codesqueak/7_Segment_Clock/README.md

# 7 Segment 24 Hour LED Clock

A pure logic, 7 segment 24 hour clock using large 7 segment displays

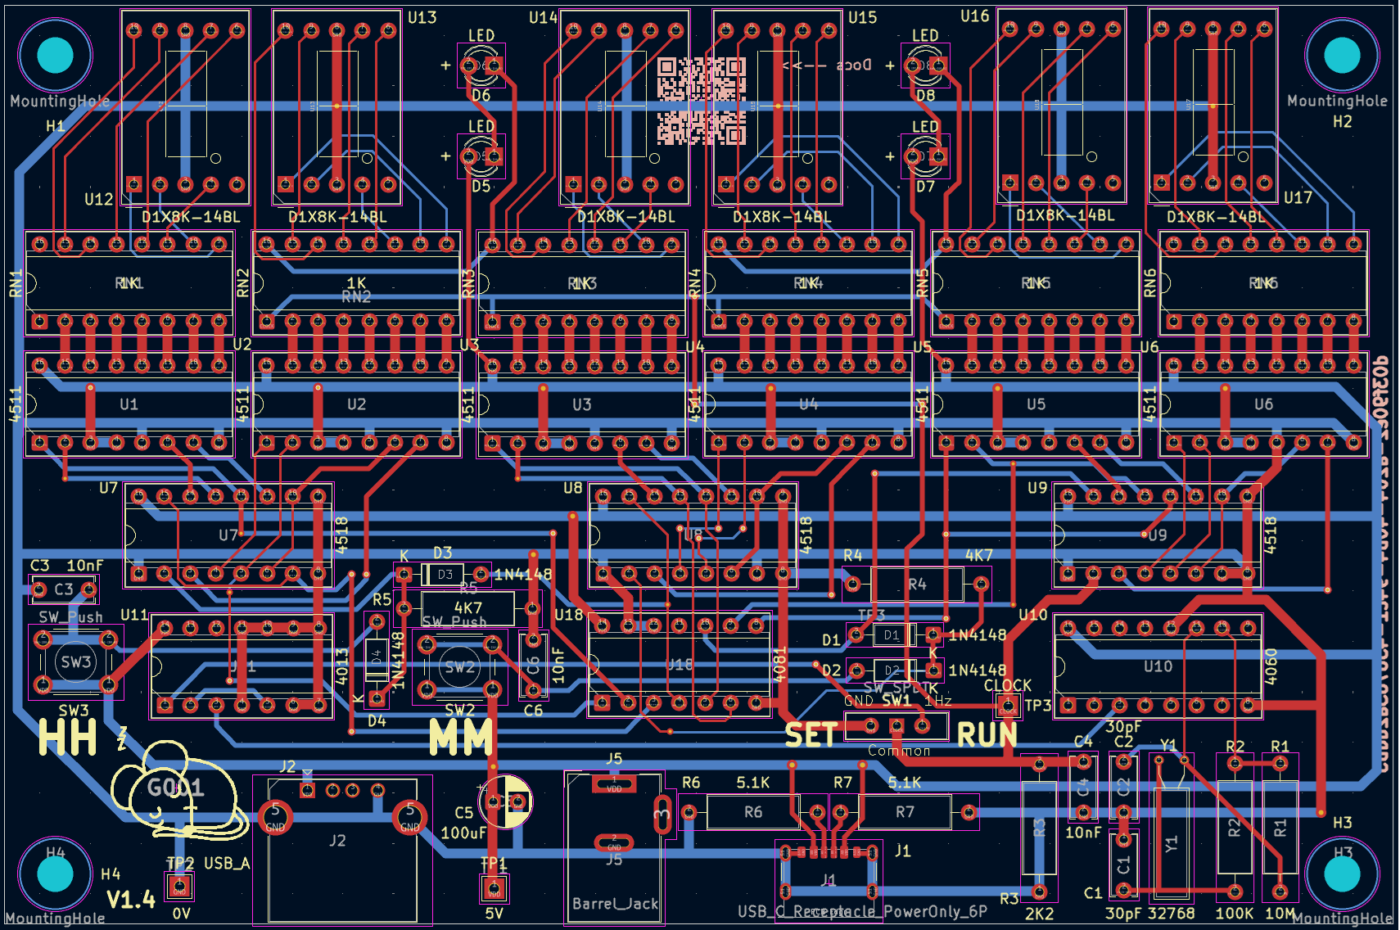
[picture p1: circuit.png]
PCB Circuit Layout
