codesqueak/7_Segment_Clock/kicad/clock.kicad_pcb

## KiCad design kicad/clock.kicad_pcb (2026-01-08)

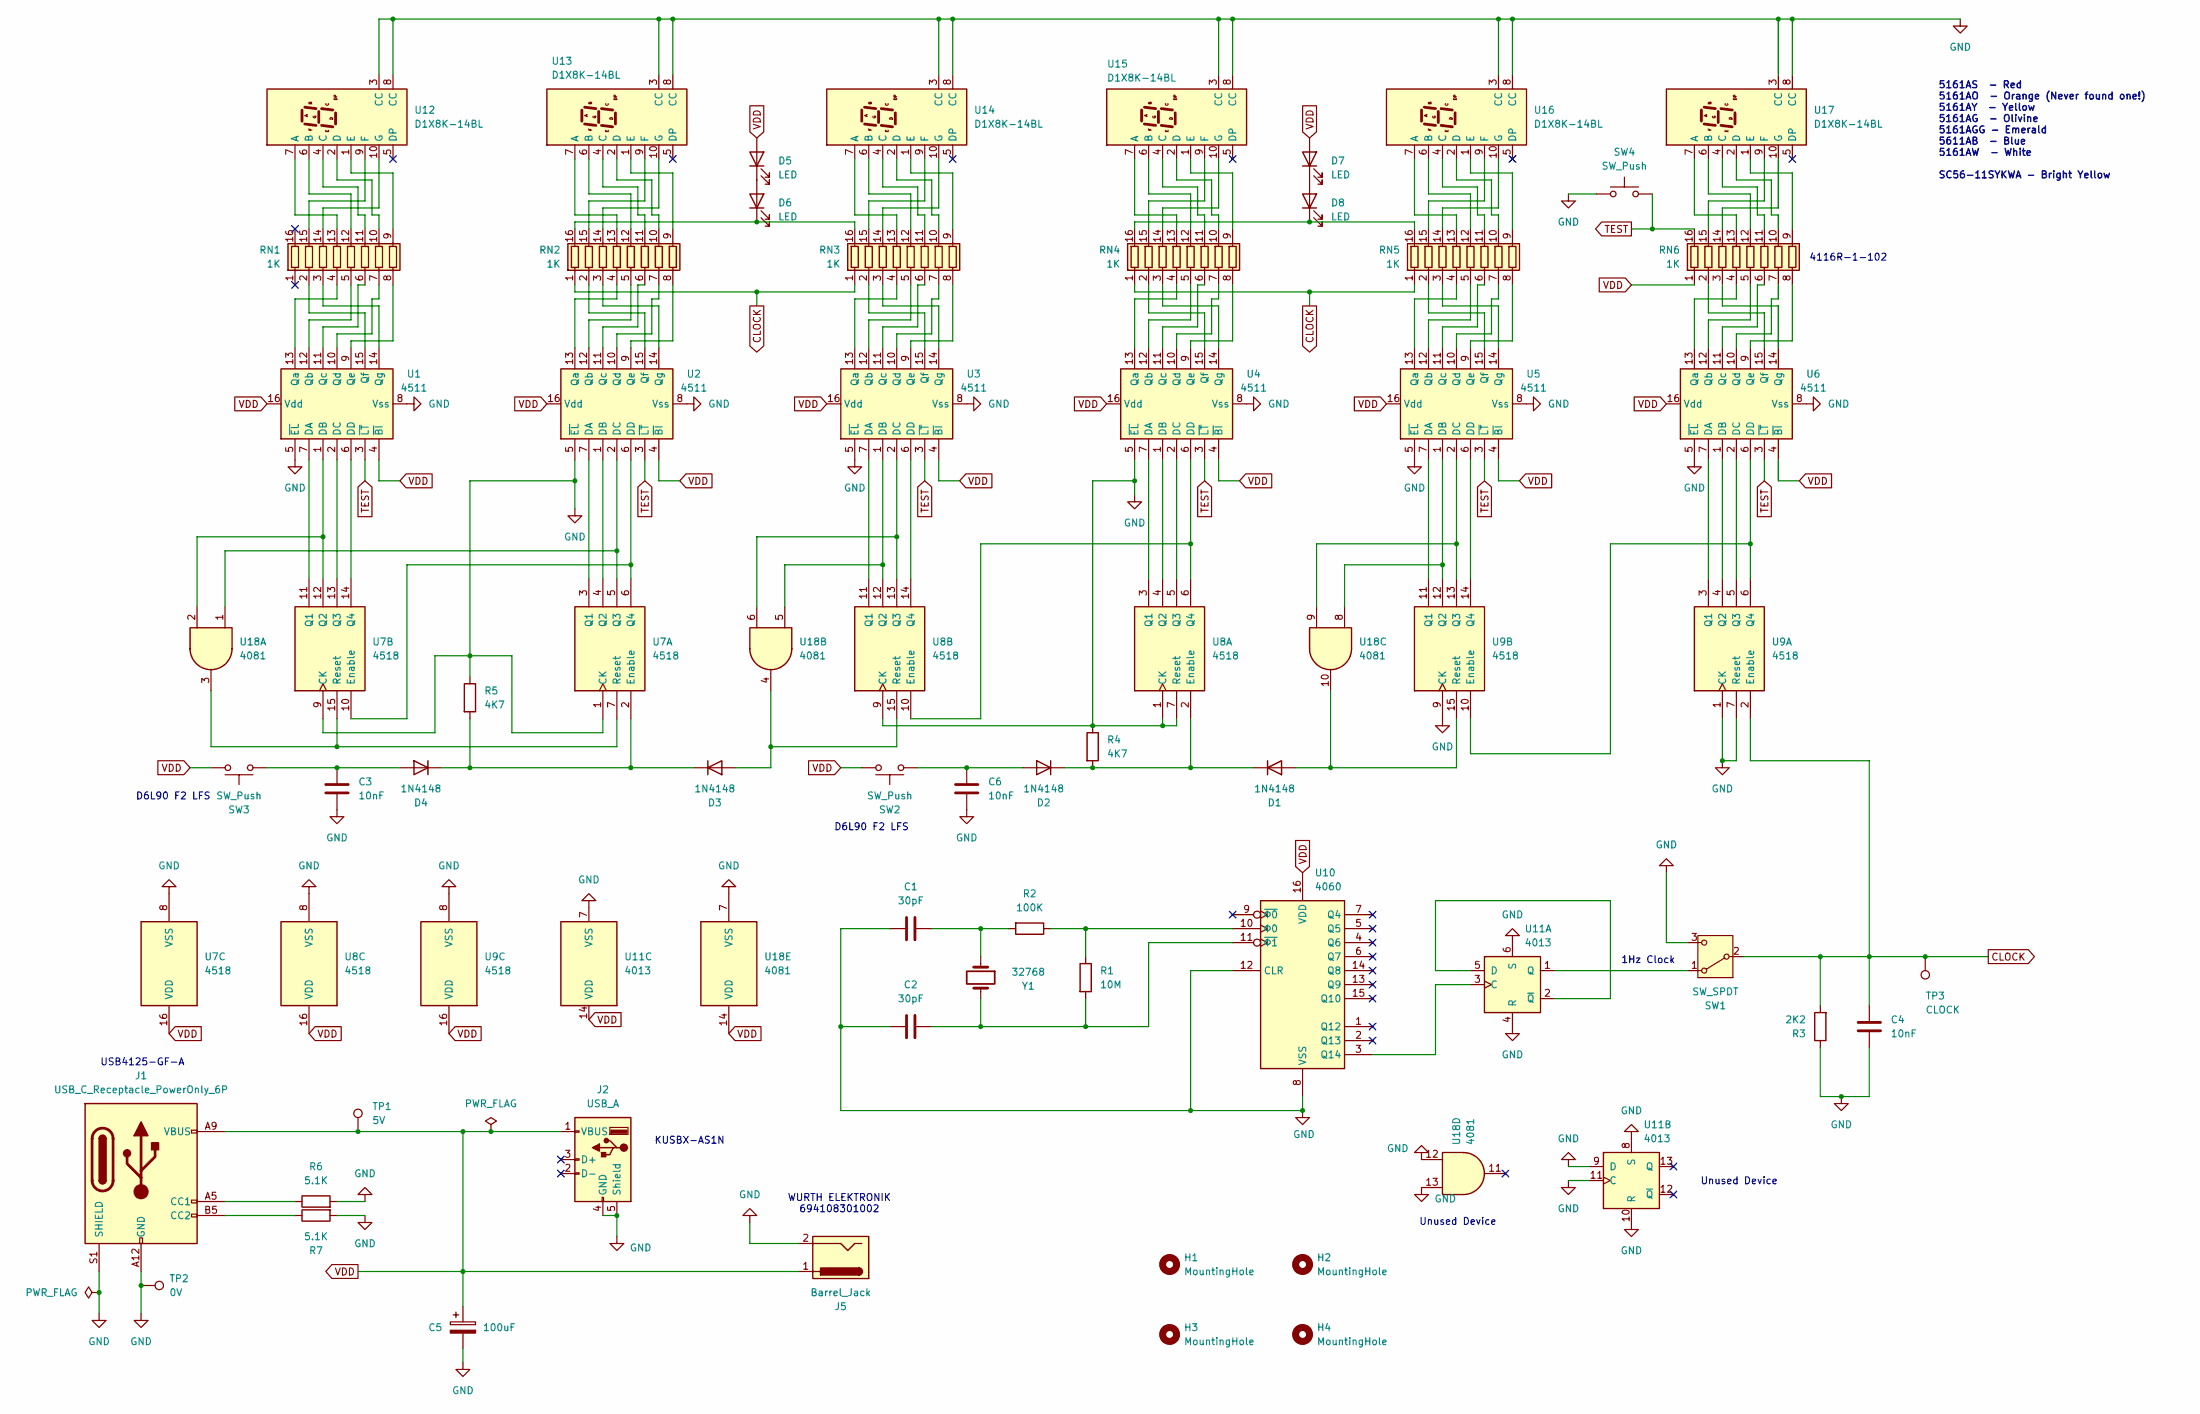
[picture p11: schematic clock.kicad_sch, Logic Clock]

Parts:
C1, C2: 30pF; C_Disc_D6.0mm_W2.5mm_P5.00mm
C3, C4, C6: 10nF; C_Disc_D6.0mm_W2.5mm_P5.00mm
C5: 100uF; CP_Radial_D5.0mm_P2.50mm
D1, D2, D3, D4: 1N4148; D_DO-35_SOD27_P7.62mm_Horizontal
D5, D6, D7, D8: LED; LED_D3.0mm
H1, H2, H3, H4: MountingHole; MountingHole_3.5mm
J1: USB_C_Receptacle_PowerOnly_6P; USB_C_Receptacle_GCT_USB4125-xx-x-0190_6P_TopMnt_Horizontal
J2: USB_A; USB_A_Kycon_KUSBX-AS1N-B_Horizontal
J5: Barrel_Jack; BarrelJack_Wuerth_6941xx301002
R1: 10M; R_Axial_DIN0309_L9.0mm_D3.2mm_P12.70mm_Horizontal
R2: 100K; R_Axial_DIN0309_L9.0mm_D3.2mm_P12.70mm_Horizontal
R3: 2K2; R_Axial_DIN0309_L9.0mm_D3.2mm_P12.70mm_Horizontal
R4, R5: 4K7; R_Axial_DIN0309_L9.0mm_D3.2mm_P12.70mm_Horizontal
R6, R7: 5.1K; R_Axial_DIN0309_L9.0mm_D3.2mm_P12.70mm_Horizontal
RN1, RN2, RN3, RN4, RN5, RN6: 1K; DIP-16_W7.62mm_Socket
SW1: SW_SPDT; SW_Slide-03_Pin-2-Common_10x2.5x6.4_P2.54mm
SW2, SW3, SW4: SW_Push; SW_PUSH_6mm_H5mm
TP1: 5V; TestPoint_THTPad_2.0x2.0mm_Drill1.0mm
TP2: 0V; TestPoint_THTPad_2.0x2.0mm_Drill1.0mm
TP3: CLOCK; TestPoint_THTPad_2.0x2.0mm_Drill1.0mm
U1, U2, U3, U4, U5, U6: 4511; DIP-16_W7.62mm_Socket
U7, U8, U9: 4518; DIP-16_W7.62mm_Socket
U10: 4060; DIP-16_W7.62mm_Socket
U11: 4013; DIP-14_W7.62mm_Socket
U12, U13, U14, U15, U16, U17: D1X8K-14BL; D1X8K
U18: 4081; DIP-14_W7.62mm_Socket
Y1: 32768; Crystal_AT310_D3.0mm_L10.0mm_Horizontal

Connections:
CLOCK: C4.1, R3.2, RN2.1 (R1.1), RN3.1 (R1.1), RN4.1 (R1.1), RN5.1 (R1.1), SW1.2 (B), TP3.1, U9.2 (Enable)
GND: C1.1, C2.1, C3.2, C4.2, C5.2, C6.2, J1.A12 (GND), J1.B12 (GND), J1.S1 (SHIELD), J2.4 (GND), J2.5 (Shield), J5.2, R3.1, R4.1, R5.1, R6.2, R7.2, SW1.3 (C), SW4.2, TP2.1, U1.5 (~EL), U1.8 (Vss), U2.5 (~EL), U2.8 (Vss), U3.5 (~EL), U3.8 (Vss), U4.5 (~EL), U4.8 (Vss), U5.5 (~EL), U5.8 (Vss), U6.5 (~EL), U6.8 (Vss), U7.1 (CK), U7.8 (VSS), U7.9 (CK), U8.1 (CK), U8.7 (Reset), U8.8 (VSS), U8.9 (CK), U9.1 (CK), U9.7 (Reset), U9.8 (VSS), U9.9 (CK), U10.8 (VSS), U10.12 (CLR), U11.4 (R), U11.6 (S), U11.7 (VSS), U11.8 (S), U11.9 (D), U11.10 (R), U11.11 (C), U12.3 (CC), U12.8 (CC), U13.3 (CC), U13.8 (CC), U14.3 (CC), U14.8 (CC), U15.3 (CC), U15.8 (CC), U16.3 (CC), U16.8 (CC), U17.3 (CC), U17.8 (CC), U18.7 (VSS), U18.12, U18.13
unnamed: C1.2, R2.2, Y1.1
unnamed: D1.2 (A), U9.15 (Reset), U18.10
unnamed: D1.1 (K), D2.1 (K), R4.2, U8.2 (Enable)
unnamed: C6.1, D2.2 (A), SW2.2
unnamed: D3.2 (A), U8.15 (Reset), U18.4
unnamed: D3.1 (K), D4.1 (K), R5.2, U7.2 (Enable)
unnamed: C3.1, D4.2 (A), SW3.2
unnamed: D5.1 (K), D6.2 (A)
unnamed: D6.1 (K), RN2.16 (R1.2), RN3.16 (R1.2)
unnamed: D7.1 (K), D8.2 (A)
unnamed: D8.1 (K), RN4.16 (R1.2), RN5.16 (R1.2)
unnamed: J1.A5 (CC1), R6.1
unnamed: J1.B5 (CC2), R7.1
unnamed: RN1.2 (R2.1), U1.15 (Qf)
unnamed: RN1.15 (R2.2), U12.9 (F)
unnamed: RN1.3 (R3.1), U1.14 (Qg)
unnamed: RN1.14 (R3.2), U12.10 (G)
unnamed: RN1.4 (R4.1), U1.13 (Qa)
unnamed: RN1.13 (R4.2), U12.7 (A)
unnamed: RN1.5 (R5.1), U1.12 (Qb)
unnamed: RN1.12 (R5.2), U12.6 (B)
unnamed: RN1.6 (R6.1), U1.11 (Qc)
unnamed: RN1.11 (R6.2), U12.4 (C)
unnamed: RN1.7 (R7.1), U1.10 (Qd)
unnamed: RN1.10 (R7.2), U12.2 (D)
unnamed: RN1.8 (R8.1), U1.9 (Qe)
unnamed: RN1.9 (R8.2), U12.1 (E)
unnamed: RN2.2 (R2.1), U2.15 (Qf)
unnamed: RN2.15 (R2.2), U13.9 (F)
unnamed: RN2.3 (R3.1), U2.14 (Qg)
unnamed: RN2.14 (R3.2), U13.10 (G)
unnamed: RN2.4 (R4.1), U2.13 (Qa)
unnamed: RN2.13 (R4.2), U13.7 (A)
unnamed: RN2.5 (R5.1), U2.12 (Qb)
unnamed: RN2.12 (R5.2), U13.6 (B)
unnamed: RN2.6 (R6.1), U2.11 (Qc)
unnamed: RN2.11 (R6.2), U13.4 (C)
unnamed: RN2.7 (R7.1), U2.10 (Qd)
unnamed: RN2.10 (R7.2), U13.2 (D)
unnamed: RN2.8 (R8.1), U2.9 (Qe)
unnamed: RN2.9 (R8.2), U13.1 (E)
unnamed: RN3.2 (R2.1), U3.15 (Qf)
unnamed: RN3.15 (R2.2), U14.9 (F)
unnamed: RN3.3 (R3.1), U3.14 (Qg)
unnamed: RN3.14 (R3.2), U14.10 (G)
unnamed: RN3.4 (R4.1), U3.13 (Qa)
unnamed: RN3.13 (R4.2), U14.7 (A)
unnamed: RN3.5 (R5.1), U3.12 (Qb)
unnamed: RN3.12 (R5.2), U14.6 (B)
unnamed: RN3.6 (R6.1), U3.11 (Qc)
unnamed: RN3.11 (R6.2), U14.4 (C)
unnamed: RN3.7 (R7.1), U3.10 (Qd)
unnamed: RN3.10 (R7.2), U14.2 (D)
unnamed: RN3.8 (R8.1), U3.9 (Qe)
unnamed: RN3.9 (R8.2), U14.1 (E)
unnamed: RN4.2 (R2.1), U4.15 (Qf)
unnamed: RN4.15 (R2.2), U15.9 (F)
unnamed: RN4.3 (R3.1), U4.14 (Qg)
unnamed: RN4.14 (R3.2), U15.10 (G)
unnamed: RN4.4 (R4.1), U4.13 (Qa)
unnamed: RN4.13 (R4.2), U15.7 (A)
unnamed: RN4.5 (R5.1), U4.12 (Qb)
unnamed: RN4.12 (R5.2), U15.6 (B)
unnamed: RN4.6 (R6.1), U4.11 (Qc)
unnamed: RN4.11 (R6.2), U15.4 (C)
unnamed: RN4.7 (R7.1), U4.10 (Qd)
unnamed: RN4.10 (R7.2), U15.2 (D)
unnamed: RN4.8 (R8.1), U4.9 (Qe)
unnamed: RN4.9 (R8.2), U15.1 (E)
unnamed: RN5.2 (R2.1), U5.15 (Qf)
unnamed: RN5.15 (R2.2), U16.9 (F)
unnamed: RN5.3 (R3.1), U5.14 (Qg)
unnamed: RN5.14 (R3.2), U16.10 (G)
unnamed: RN5.4 (R4.1), U5.13 (Qa)
unnamed: RN5.13 (R4.2), U16.7 (A)
unnamed: RN5.5 (R5.1), U5.12 (Qb)
unnamed: RN5.12 (R5.2), U16.6 (B)
unnamed: RN5.6 (R6.1), U5.11 (Qc)
unnamed: RN5.11 (R6.2), U16.4 (C)
unnamed: RN5.7 (R7.1), U5.10 (Qd)
unnamed: RN5.10 (R7.2), U16.2 (D)
unnamed: RN5.8 (R8.1), U5.9 (Qe)
unnamed: RN5.9 (R8.2), U16.1 (E)
unnamed: RN6.2 (R2.1), U6.15 (Qf)
unnamed: RN6.15 (R2.2), U17.9 (F)
unnamed: RN6.3 (R3.1), U6.14 (Qg)
unnamed: RN6.14 (R3.2), U17.10 (G)
unnamed: RN6.4 (R4.1), U6.13 (Qa)
unnamed: RN6.13 (R4.2), U17.7 (A)
unnamed: RN6.5 (R5.1), U6.12 (Qb)
unnamed: RN6.12 (R5.2), U17.6 (B)
unnamed: RN6.6 (R6.1), U6.11 (Qc)
unnamed: RN6.11 (R6.2), U17.4 (C)
unnamed: RN6.7 (R7.1), U6.10 (Qd)
unnamed: RN6.10 (R7.2), U17.2 (D)
unnamed: RN6.8 (R8.1), U6.9 (Qe)
unnamed: RN6.9 (R8.2), U17.1 (E)
unnamed: SW1.1 (A), U11.1 (Q)
unnamed: U1.7 (DA), U7.11 (Q1)
unnamed: U1.1 (DB), U7.12 (Q2), U18.2
unnamed: U1.2 (DC), U7.13 (Q3)
unnamed: U1.6 (DD), U7.14 (Q4)
unnamed: U2.7 (DA), U7.3 (Q1)
unnamed: U2.1 (DB), U7.4 (Q2)
unnamed: U2.2 (DC), U7.5 (Q3), U18.1
unnamed: U2.6 (DD), U7.6 (Q4), U7.10 (Enable)
unnamed: U3.7 (DA), U8.11 (Q1)
unnamed: U3.1 (DB), U8.12 (Q2), U18.5
unnamed: U3.2 (DC), U8.13 (Q3), U18.6
unnamed: U3.6 (DD), U8.14 (Q4)
unnamed: U4.7 (DA), U8.3 (Q1)
unnamed: U4.1 (DB), U8.4 (Q2)
unnamed: U4.2 (DC), U8.5 (Q3)
unnamed: U4.6 (DD), U8.6 (Q4), U8.10 (Enable)
unnamed: U5.7 (DA), U9.11 (Q1)
unnamed: U5.1 (DB), U9.12 (Q2), U18.8
unnamed: U5.2 (DC), U9.13 (Q3), U18.9
unnamed: U5.6 (DD), U9.14 (Q4)
unnamed: U6.7 (DA), U9.3 (Q1)
unnamed: U6.1 (DB), U9.4 (Q2)
unnamed: U6.2 (DC), U9.5 (Q3)
unnamed: U6.6 (DD), U9.6 (Q4), U9.10 (Enable)
unnamed: U7.7 (Reset), U7.15 (Reset), U18.3
unnamed: U10.3 (Q14), U11.3 (C)
unnamed: C2.2, R1.2, U10.11 (~Φ1), Y1.2
unnamed: R1.1, R2.1, U10.10 (Φ0)
unnamed: U11.2 (~Q), U11.5 (D)
TEST: RN6.16 (R1.2), SW4.1, U1.3 (~LT), U2.3 (~LT), U3.3 (~LT), U4.3 (~LT), U5.3 (~LT), U6.3 (~LT)
VDD: C5.1, D5.2 (A), D7.2 (A), J1.A9 (VBUS), J1.B9 (VBUS), J2.1 (VBUS), J5.1, RN6.1 (R1.1), SW2.1, SW3.1, TP1.1, U1.4 (~BI), U1.16 (Vdd), U2.4 (~BI), U2.16 (Vdd), U3.4 (~BI), U3.16 (Vdd), U4.4 (~BI), U4.16 (Vdd), U5.4 (~BI), U5.16 (Vdd), U6.4 (~BI), U6.16 (Vdd), U7.16 (VDD), U8.16 (VDD), U9.16 (VDD), U10.16 (VDD), U11.14 (VDD), U18.14 (VDD)

Notes on the sheet:
Unused Device
USB4125-GF-A
5161AS - Red 5161AO - Orange (Never found one!) 5161AY - Yellow 5161AG - Olivine 5161AGG - Emerald 5611AB - Blue 5161AW - White SC56-11SYKWA - Bright Yellow
D6L90 F2 LFS
WURTH ELEKTRONIK 694108301002
4116R-1-102
1Hz Clock
KUSBX-AS1N

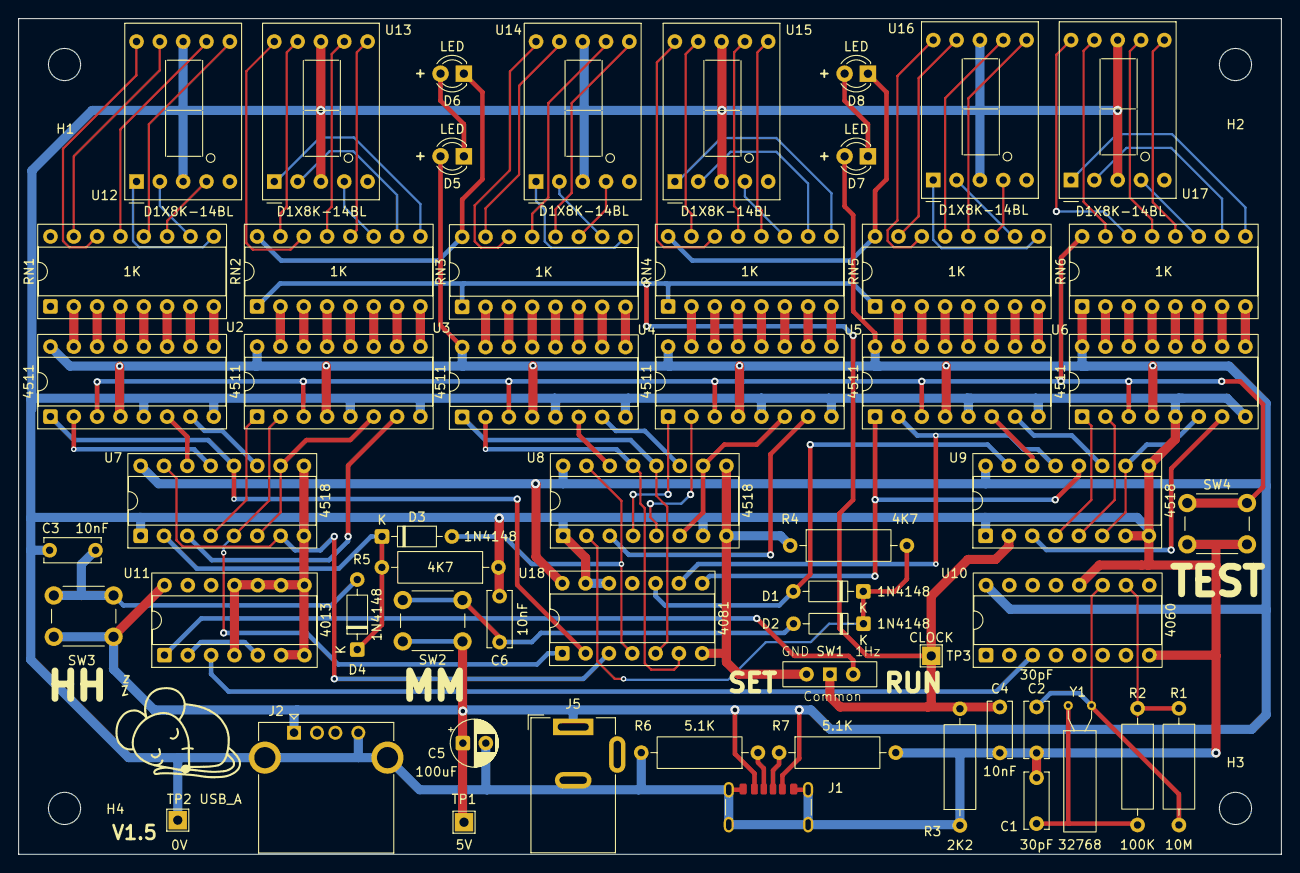
[picture p12: board clock.kicad_pcb from above]

Board: 2 copper layers, 137.5 x 91.0 mm, 62 parts (1 on the bottom side), 131 nets.

Other parts of the board:
G001: LOGO; sleepymouse_very_small
G001#2: LOGO; qr-code
