codesqueak/7_Segment_Clock/(commit log)

2025-11-17 Fist upload
    [clock.kicad_pcb, clock.kicad_sch]
2025-11-17 Add qr code etc
    [clock.kicad_pcb]
2025-12-17 Update docs
    [clock.kicad_pcb, clock.kicad_sch]
